u-blox/blueprint-B200-NINA-B1/README.md

# blueprint-B200-NINA-B1
This blueprint is a small battery powered solution with the NINA-B1 Bluetooth Low Energy module from u-blox.
- Provides a reference for integration of u-blox BLE module and a sensor for IoT applications. 
- Gives an example of components choice, placement, and layout.

The board has been created to match the size of a 20mm coin cell battery providing a small form factor solution.

An iPhone app is available that can be used to test features on the blueprint. The app can display
the accelerometer and gyro data as a rotating 3D image of the NINA module. The app can also control the red and green LED and 
it display the temperature, RSSI value and battery level.

This app is available on the App Store and github.

https://itunes.apple.com/us/app/u-blox-ble/id575523395?mt=8

https://github.com/u-blox/iOS-u-blox-BLE

https://www.u-blox.com/

## Disclaimer
Copyright (C) u-blox 

u-blox reserves all rights in this deliverable (documentation, software, etc.,
hereafter “Deliverable”). 

u-blox grants you the right to use, copy, modify and distribute the
Deliverable provided hereunder for any purpose without fee.

THIS DELIVERABLE IS BEING PROVIDED "AS IS", WITHOUT ANY EXPRESS OR IMPLIED
WARRANTY. IN PARTICULAR, NEITHER THE AUTHOR NOR U-BLOX MAKES ANY
REPRESENTATION OR WARRANTY OF ANY KIND CONCERNING THE MERCHANTABILITY OF THIS
DELIVERABLE OR ITS FITNESS FOR ANY PARTICULAR PURPOSE.

In case you provide us a feedback or make a contribution in the form of a
further development of the Deliverable (“Contribution”), u-blox will have the
same rights as granted to you, namely to use, copy, modify and distribute the
Contribution provided to us for any purpose without fee.
