u-blox/blueprint-B200-NINA-B1/Schematic/B200_Blueprint_Schematic.pdf

# BOSCH SENSOR

# RGB LED

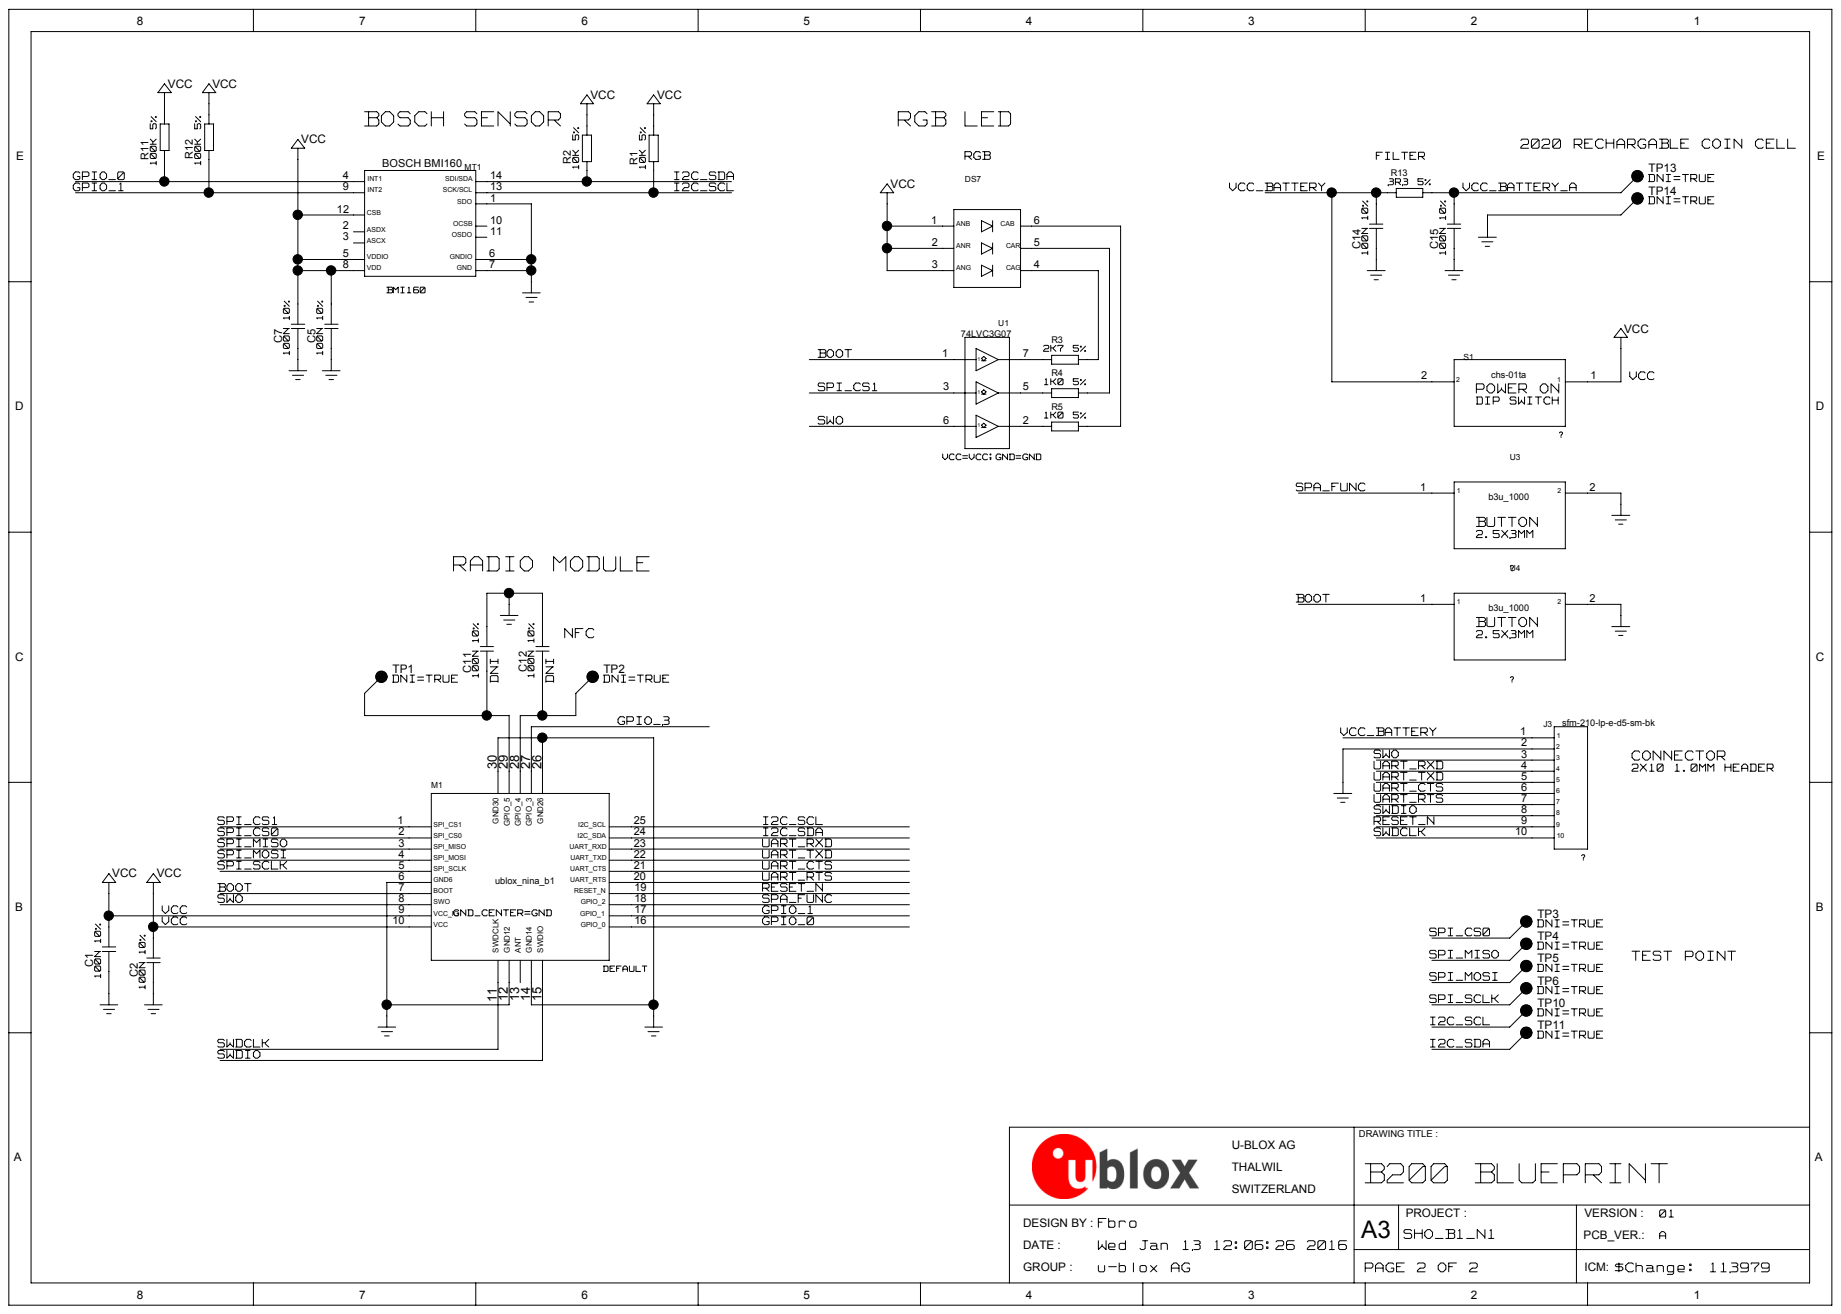
[picture p1: page 1]

VCC=VCC;GND=GND
