u-blox/blueprint-B200-NINA-B1/Schematic/B200_Blueprint_Schematic_debug_board.pdf

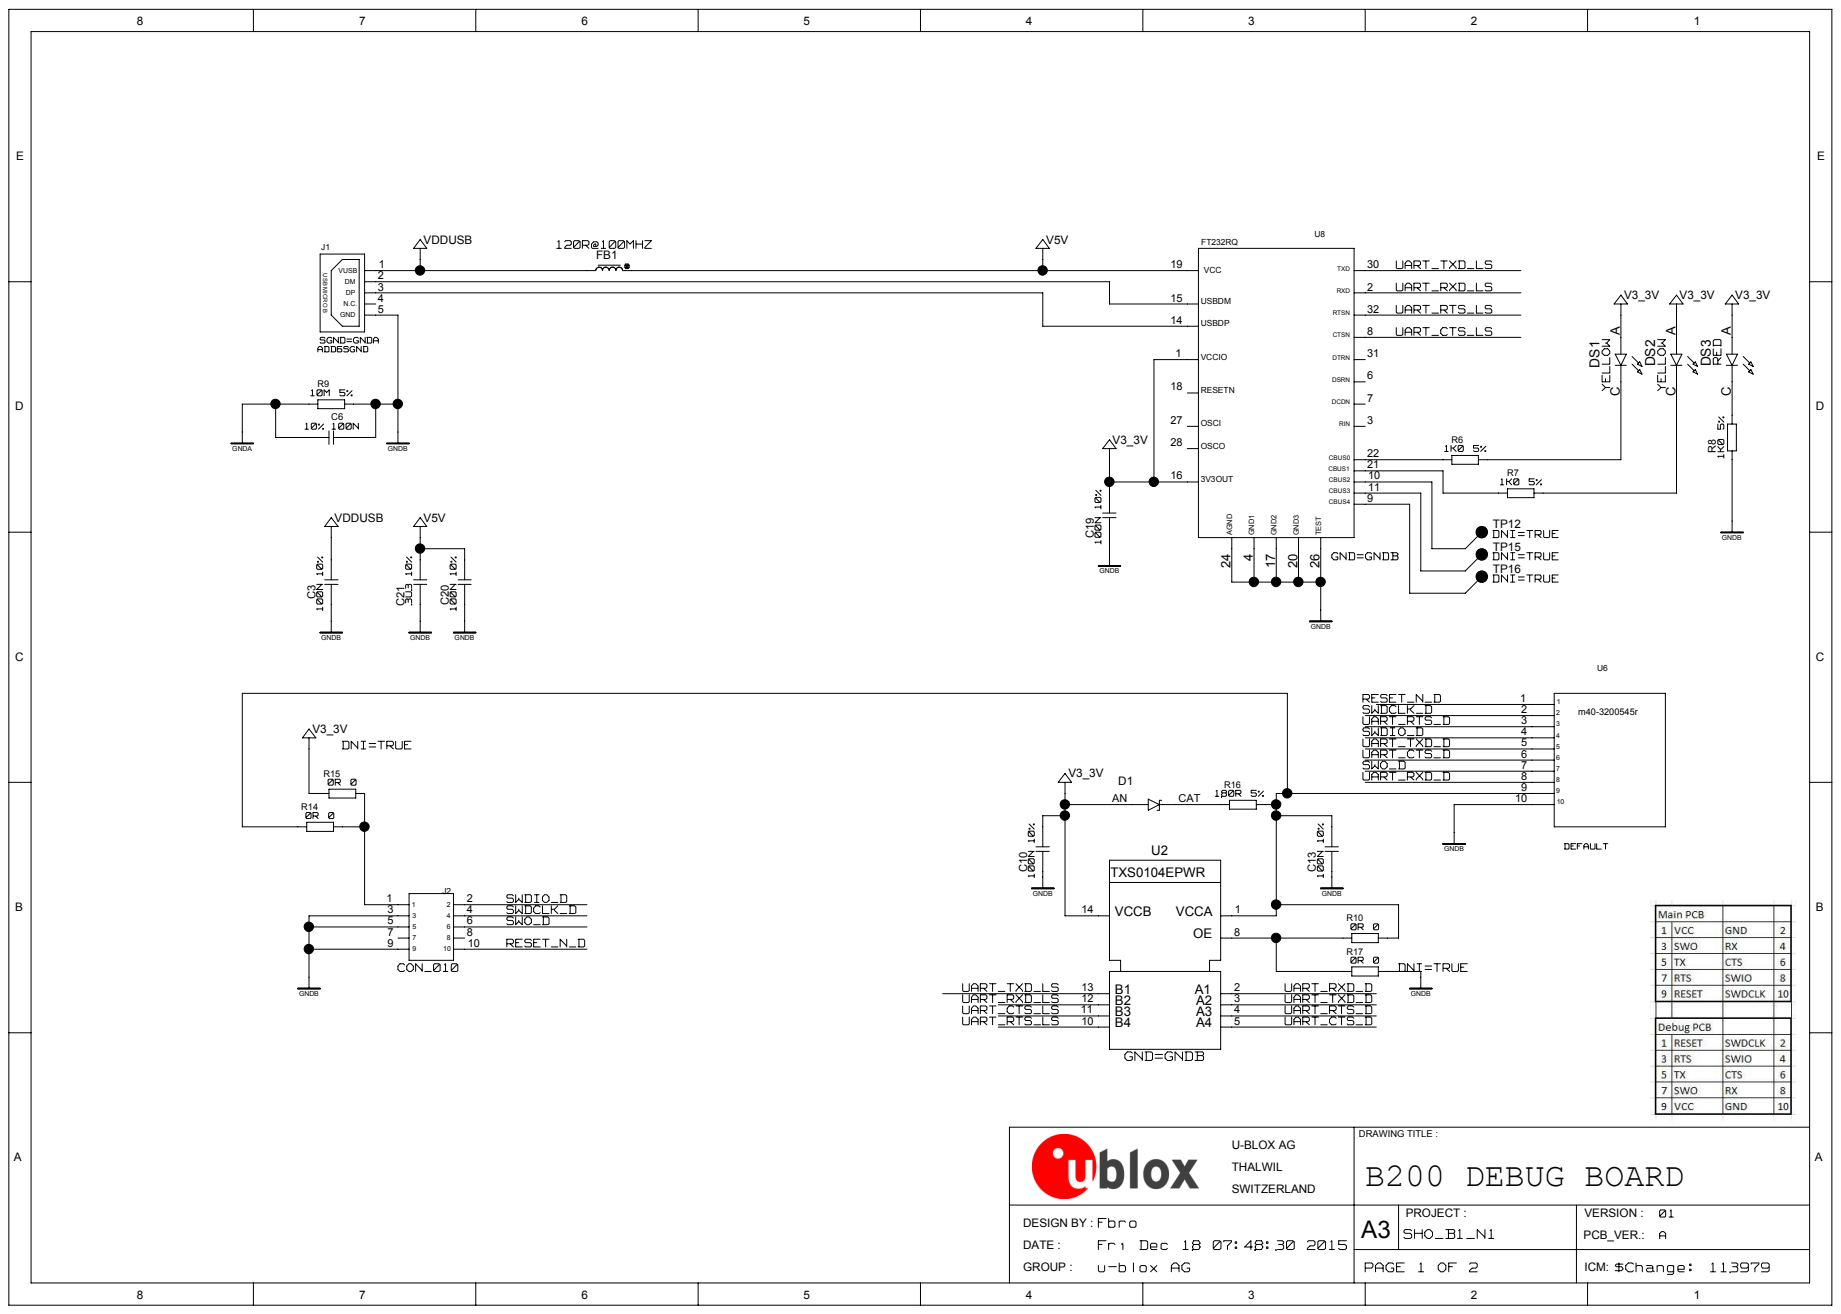
[picture p2: page 1]
