u-blox/blueprint-B200-NINA-B1/PCB_data/B200_NINA_CAD.pdf

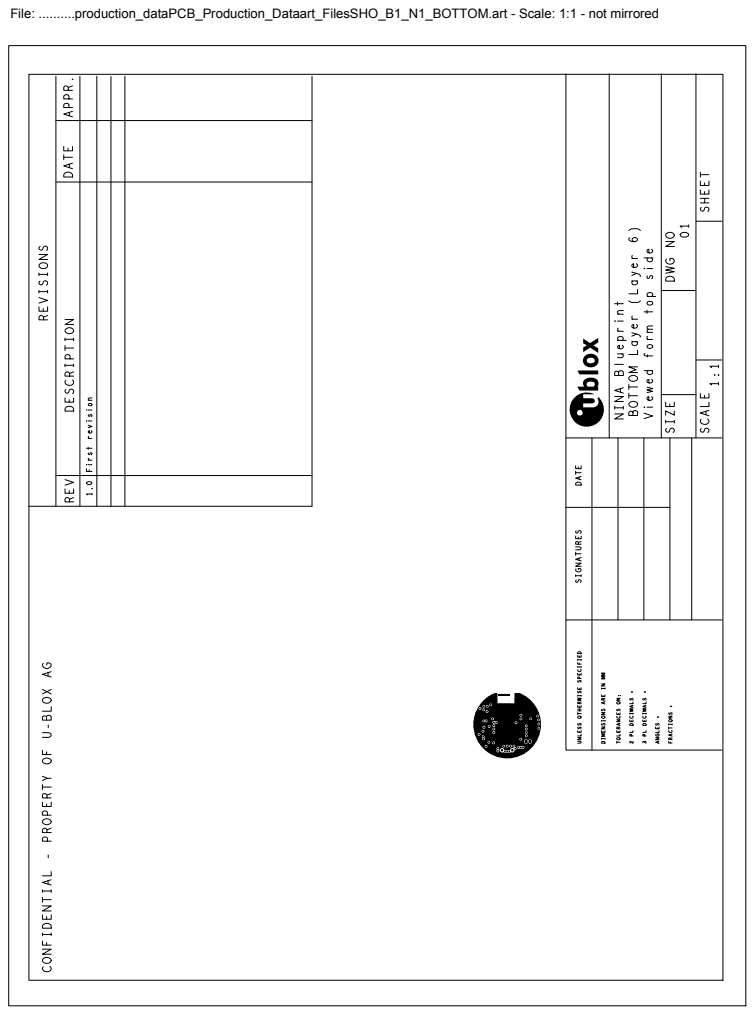
[picture p3: page 1]

File: ..........production_dataPCB_Production_Dataart_FilesSHO_B1_N1_BOTTOM.art - Scale: 1:1 - not mirrored

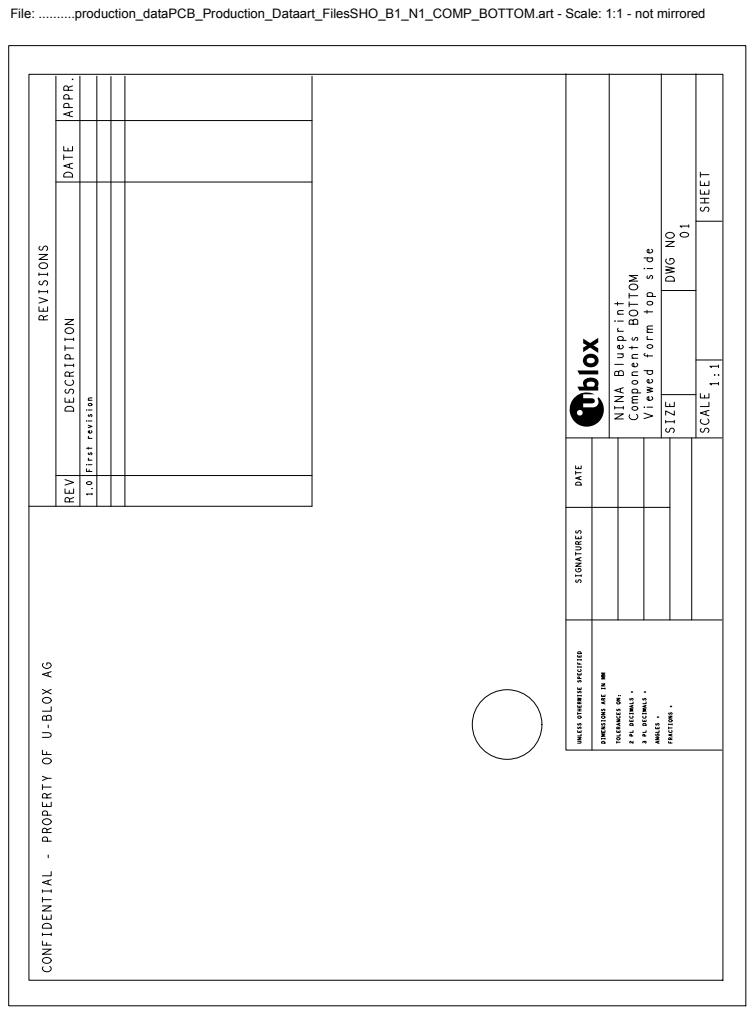
[picture p4: page 2]

File: ..........production_dataPCB_Production_Dataart_FilesSHO_B1_N1_COMP_BOTTOM.art - Scale: 1:1 - not mirrored

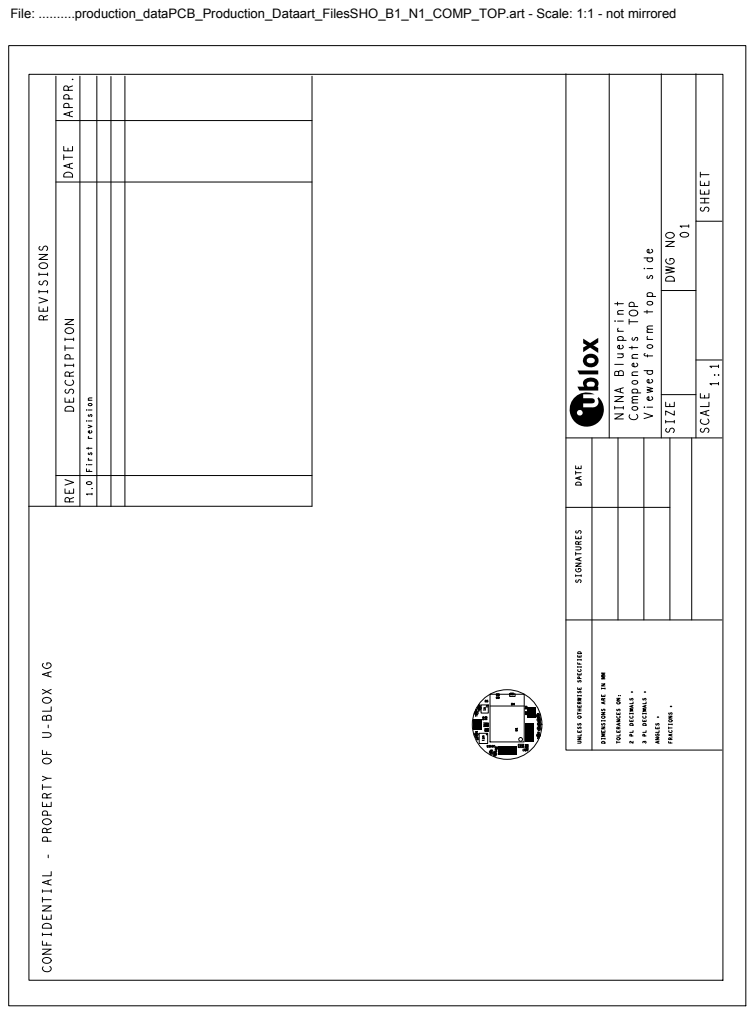
[picture p5: page 3]

File: ..........production_dataPCB_Production_Dataart_FilesSHO_B1_N1_COMP_TOP.art - Scale: 1:1 - not mirrored

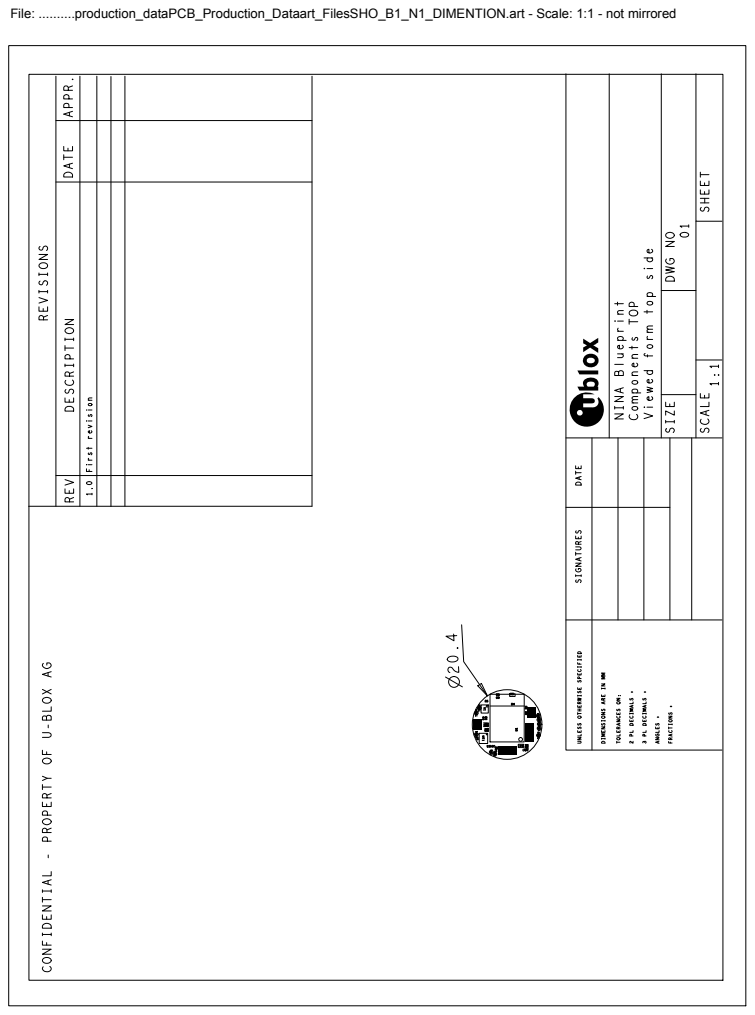
[picture p6: page 4]

File: ..........production_dataPCB_Production_Dataart_FilesSHO_B1_N1_DIMENTION.art - Scale: 1:1 - not mirrored

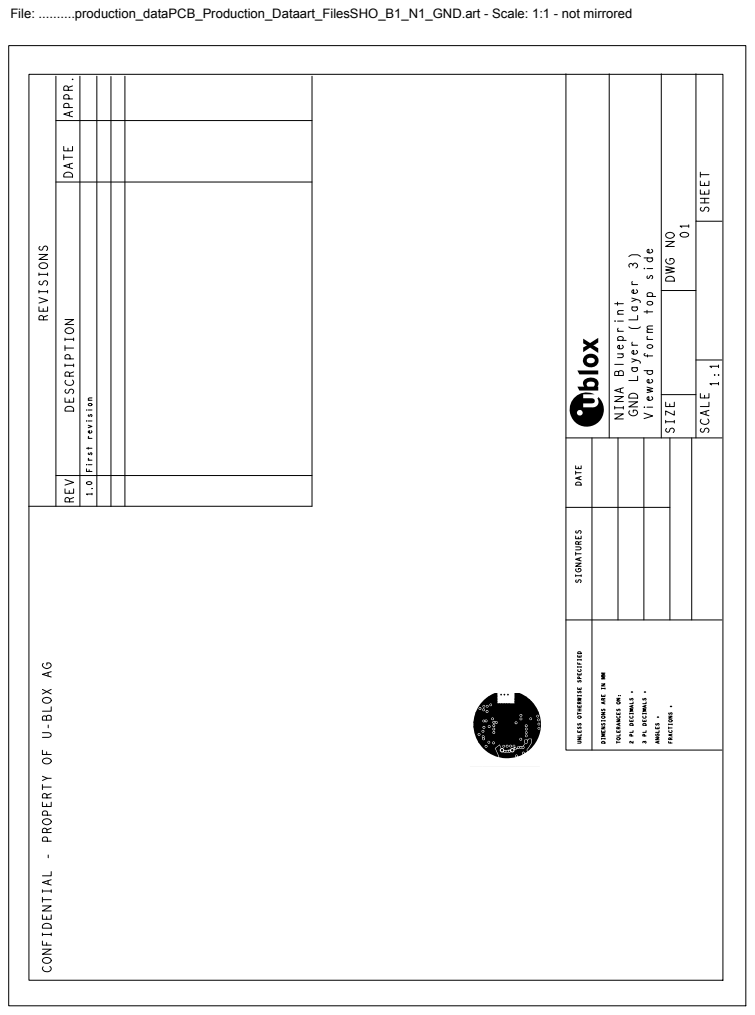
[picture p7: page 5]

File: ..........production_dataPCB_Production_Dataart_FilesSHO_B1_N1_GND.art - Scale: 1:1 - not mirrored

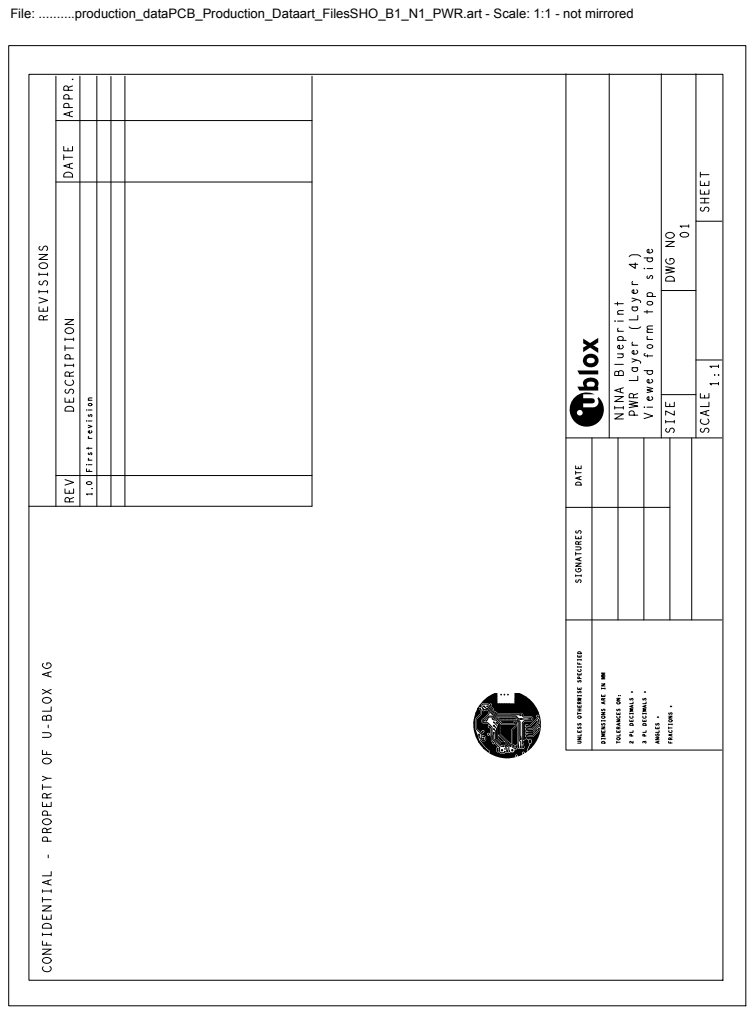
[picture p8: page 6]

File: ..........production_dataPCB_Production_Dataart_FilesSHO_B1_N1_PWR.art - Scale: 1:1 - not mirrored

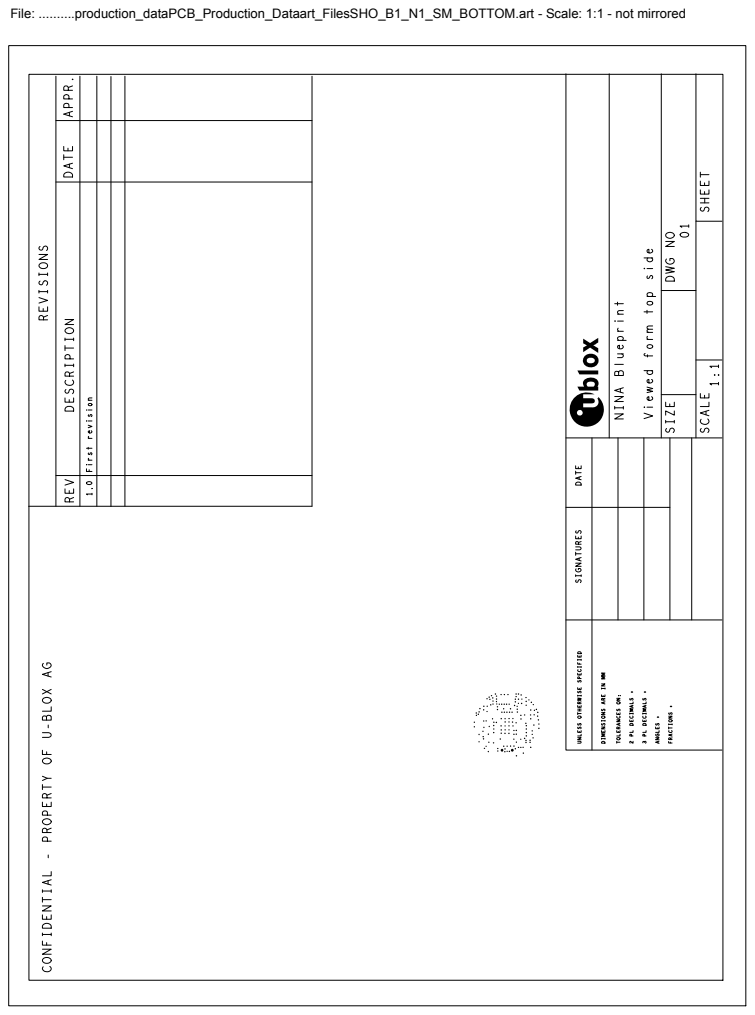
[picture p9: page 7]

File: ..........production_dataPCB_Production_Dataart_FilesSHO_B1_N1_SM_BOTTOM.art - Scale: 1:1 - not mirrored

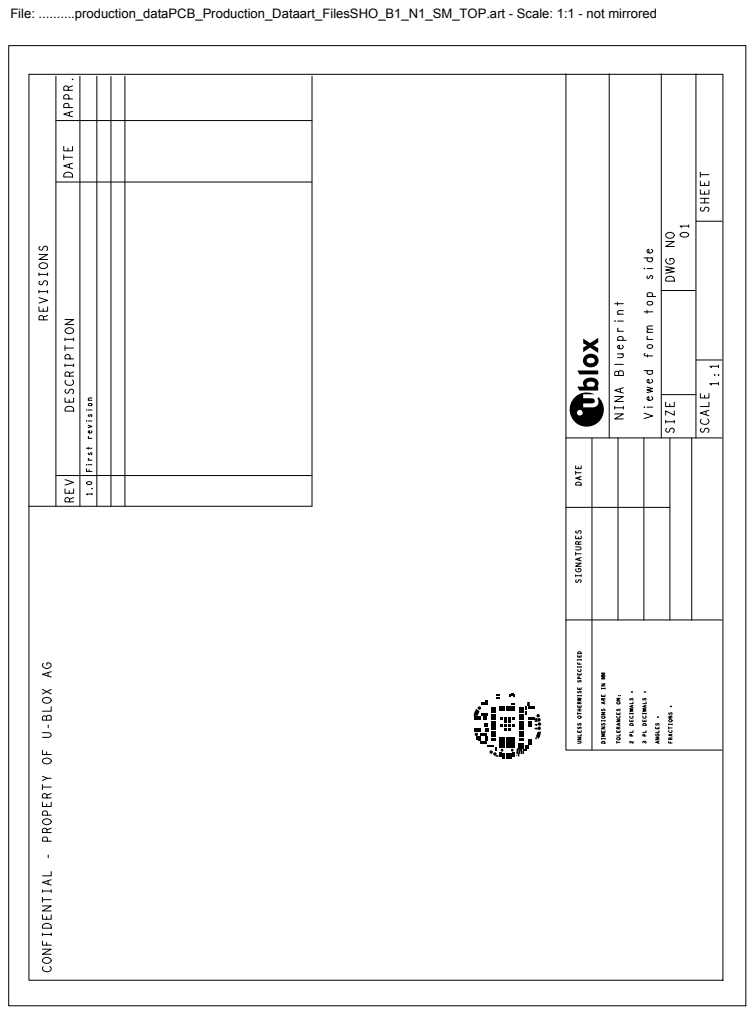
[picture p10: page 8]

File: ..........production_dataPCB_Production_Dataart_FilesSHO_B1_N1_SM_TOP.art - Scale: 1:1 - not mirrored

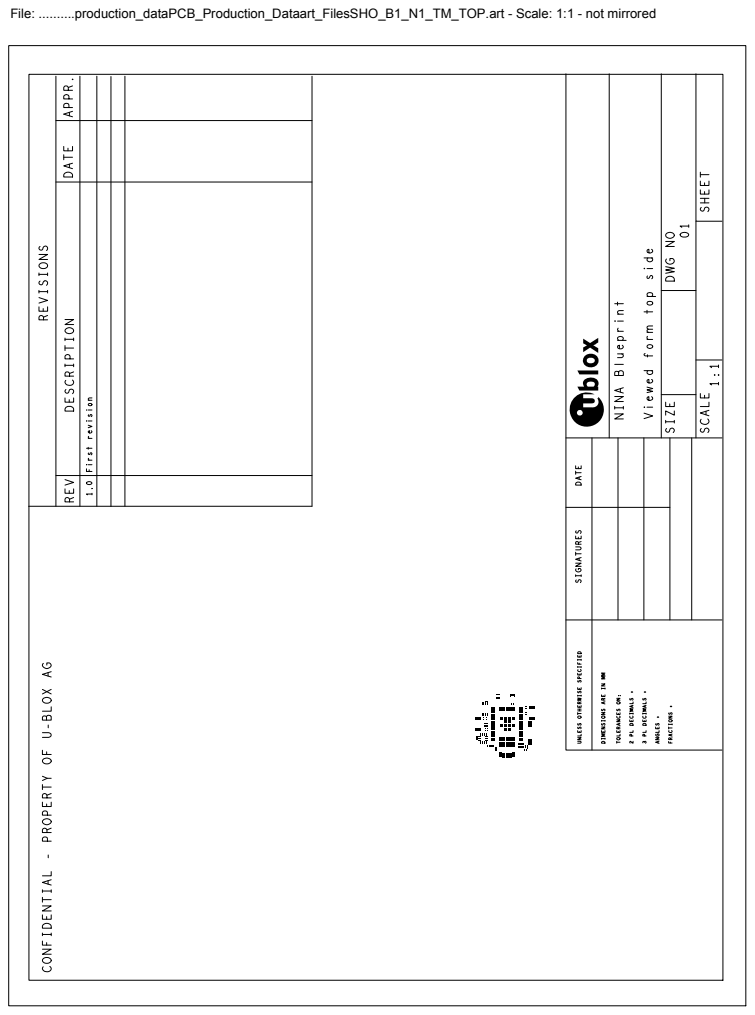
[picture p11: page 9]

File: ..........production_dataPCB_Production_Dataart_FilesSHO_B1_N1_TM_TOP.art - Scale: 1:1 - not mirrored

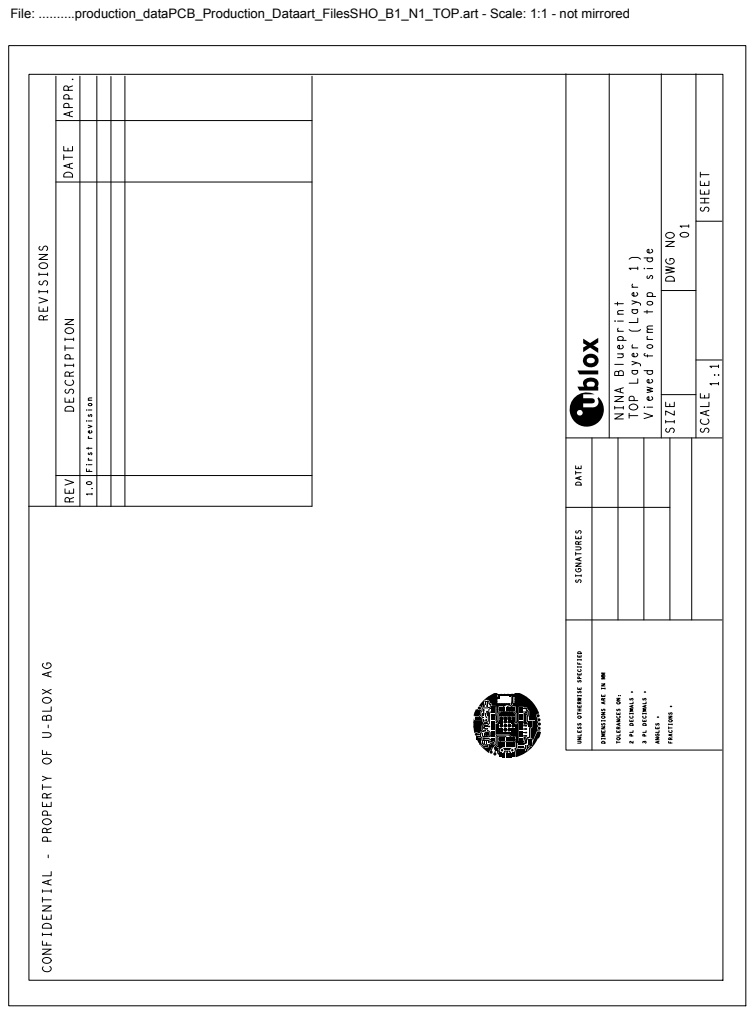
[picture p12: page 10]

File: ..........production_dataPCB_Production_Dataart_FilesSHO_B1_N1_TOP.art - Scale: 1:1 - not mirrored
